BaktiyarBr/FB2ETH_RTL8213B/FB2ETH/production/bom.csv

Designator | Footprint | Quantity | Value | LCSC Part #
C19, C20 | 1206 | 2 | 22u
C25, C34 | 1206 | 2 | 10u
CN1 | CONN-SMD_20P-P0.80_HCTL_HC-SFP-20P | 1 | HC-SFP-20P
J1 | JST_SH_SM06B-SRSS-TB_1x06-1MP_P1.00mm_Horizontal | 1 | Conn_01x06_MountingPin
L1 | L_Changjiang_FTC252012S | 1 | 2u2
L2 | L_Changjiang_FXL0420 | 1 | 10uH
P6S1, P6S2, PWR1 | 0402 | 3 | ~
R8 | 0402 | 1 | 43k
U1 | VQFN-40-1EP_5x5mm_P0.4mm_EP3.7x3.7mm_ThermalVias | 1 | RTL8213B-CG
U3 | QFN-8_L3.0-W3.0-P0.65-BL | 1 | MP9943GQ-Z
U6 | TH_HC-SFP-01L | 1 | ~
X2 | Crystal_SMD_2016-4Pin_2.0x1.6mm | 1 | 25MHz
