BaktiyarBr/FB2ETH_RTL8213B/FB2ETH_2/FB2ETH_2/production/bom.csv

Designator | Footprint | Quantity | Value | LCSC Part #
C1, C2 | 0402 | 2 | 18pF
C15, C16, C17, C18, C21, C22, C23, C26, C27, C28, C29, C30, C31, C32, C33, C35, C36, C38, C39, C40, C41, C42, C43 | 0402 | 23 | 100n
C19, C20 | 1206 | 2 | 22u
C24 | 0603 | 1 | 100n
C25, C34 | 1206 | 2 | 10u
C37 | 0603 | 1 | 1u
CN1 | CONN-SMD_20P-P0.80_HCTL_HC-SFP-20P | 1 | HC-SFP-20P
J1 | JST_SH_SM06B-SRSS-TB_1x06-1MP_P1.00mm_Horizontal | 1 | Conn_01x06_MountingPin
L1 | L_Changjiang_FTC252012S | 1 | 2u2
L2 | L_Changjiang_FXL0420 | 1 | 10uH
P6S1, P6S2, PWR1 | 0402 | 3 | ~
R1, R10, R11, R2, R3, R4, R95 | 0402 | 7 | 4.7kΩ
R12, R7 | 0402 | 2 | 100k
R13 | 0402 | 1 | 1k
R5, R6, R99 | 0402 | 3 | 470Ω
R8 | 0402 | 1 | 43k
R82, R83, R86, R87, R90 | 0402 | 5 | 10kΩ
R9 | 0402 | 1 | 2.49kΩ
SCK1, SDA1 | TestPoint_Pad_2.0x2.0mm | 2 | ~
U1 | VQFN-40-1EP_5x5mm_P0.4mm_EP3.7x3.7mm_ThermalVias | 1 | RTL8213B-CG
U3 | QFN-8_L3.0-W3.0-P0.65-BL | 1 | MP9943GQ-Z
U6 | TH_HC-SFP-01L | 1 | ~
X2 | Crystal_SMD_2016-4Pin_2.0x1.6mm | 1 | 25MHz
