BaktiyarBr/FB2ETH_RTL8213B/FB2ETH_3/FB2ETH_3/production/bom.csv

Designator | Footprint | Quantity | Value | LCSC Part #
C19, C20 | 1206 | 2 | 22u
C25, C34 | 1206 | 2 | 10u
J1 | JST_SH_SM06B-SRSS-TB_1x06-1MP_P1.00mm_Horizontal | 1 | Conn_01x06_MountingPin
J2 | PinSocket_1x09_P2.54mm_Vertical | 1 | SFP_BIDI_01x09
L2 | L_Changjiang_FXL0420 | 1 | 10uH
P6S1, P6S2, PWR1 | 0402 | 3 | ~
R20, R21, R22, R26 | 0402 | 4 | 82
R23, R24, R25, R27 | 0402 | 4 | 130
R8 | 0402 | 1 | 43k
U1 | VQFN-40-1EP_5x5mm_P0.4mm_EP3.7x3.7mm_ThermalVias | 1 | RTL8213B-CG
U3 | QFN-8_L3.0-W3.0-P0.65-BL | 1 | MP9943GQ-Z
X2 | Crystal_SMD_2016-4Pin_2.0x1.6mm | 1 | 25MHz
