BaktiyarBr/FB2ETH_RTL8213B/FB2ETH/FB2ETH.csv

Reference | Qty | Value | DNP | Exclude from BOM | Exclude from Board | Footprint | LCSC Part Name
C19,C20 | 2 | 22u/50V |  |  |  | Capacitor_SMD:C_1206_3216Metric
C25,C34 | 2 | 10u/50V |  |  |  | Capacitor_SMD:C_1206_3216Metric
CN1 | 1 | HC-SFP-20P |  |  |  | projectLibs:CONN-SMD_20P-P0.80_HCTL_HC-SFP-20P | C2897292
J1 | 1 | Conn_01x06_MountingPin |  |  |  | Connector_JST:JST_SH_SM06B-SRSS-TB_1x06-1MP_P1.00mm_Horizontal | C3041141
L2 | 1 | 10uH |  |  |  | Inductor_SMD:L_Changjiang_FXL0420
P6S1,P6S2,PWR1 | 3 |  |  |  |  | LED_SMD:LED_0402_1005Metric
R8 | 1 | 43k |  |  |  | Resistor_SMD:R_0402_1005Metric
U1 | 1 | RTL8213B-CG |  |  |  | Package_DFN_QFN:VQFN-40-1EP_5x5mm_P0.4mm_EP3.7x3.7mm_ThermalVias | C2766076
U3 | 1 | MP9943GQ-Z |  |  |  | projectLibs:QFN-8_L3.0-W3.0-P0.65-BL | C51889390
U6 | 1 |  |  |  |  | projectLibs:TH_HC-SFP-01L | C2897291
X2 | 1 | 25MHz |  |  |  | Crystal:Crystal_SMD_2016-4Pin_2.0x1.6mm | C7301945
