BaktiyarBr/FB2ETH_RTL8213B/FB2ETH_2/FB2ETH_2/FB2ETH_2.csv

Reference | Qty | Value | DNP | Exclude from BOM | Exclude from Board | Footprint | Datasheet
C19,C20 | 2 | 22u |  |  |  | Capacitor_SMD:C_1206_3216Metric
C25,C34 | 2 | 10u |  |  |  | Capacitor_SMD:C_1206_3216Metric
CN1 | 1 | HC-SFP-20P |  |  |  | projectLibs:CONN-SMD_20P-P0.80_HCTL_HC-SFP-20P | https://atta.szlcsc.com/upload/public/pdf/source/20210914/BA7BB8E5B2F161D6EB896D34EBE70234.pdf
J1 | 1 | Conn_01x06_MountingPin |  |  |  | Connector_JST:JST_SH_SM06B-SRSS-TB_1x06-1MP_P1.00mm_Horizontal
L1 | 1 | 2u2 |  |  |  | Inductor_SMD:L_Changjiang_FTC252012S
L2 | 1 | 10uH |  |  |  | Inductor_SMD:L_Changjiang_FXL0420 | https://atta.szlcsc.com/upload/public/pdf/source/20200117/C485363_A2440626DC7482D75DD0DD56D1883FBF.pdf
P6S1,P6S2,PWR1 | 3 |  |  |  |  | LED_SMD:LED_0402_1005Metric | https://atta.szlcsc.com/upload/public/pdf/source/20200820/C130723_D39B4171A1B8D8D2F39C1DC521C0922A.pdf
R8 | 1 | 43k |  |  |  | Resistor_SMD:R_0402_1005Metric
U1 | 1 | RTL8213B-CG |  |  |  | Package_DFN_QFN:VQFN-40-1EP_5x5mm_P0.4mm_EP3.7x3.7mm_ThermalVias | https://atta.szlcsc.com/upload/public/pdf/source/20240125/4FAE948FC8054805EFA4DC6DA88B16DA.pdf
U3 | 1 | MP9943GQ-Z |  |  |  | projectLibs:QFN-8_L3.0-W3.0-P0.65-BL | 2021-05-22/374398S/94eb60b6438e46f987ac1f72df989e4b/MP9943.pdf
U6 | 1 |  |  |  |  | projectLibs:TH_HC-SFP-01L | https://atta.szlcsc.com/upload/public/pdf/source/20210914/D263BD6202628DAF148611CD07FFF2AC.pdf
X2 | 1 | 25MHz |  |  |  | Crystal:Crystal_SMD_2016-4Pin_2.0x1.6mm | https://item.szlcsc.com/datasheet/SX1B25.000F1210F30/8272198.html
