BaktiyarBr/FB2ETH_RTL8213B/from_epro/ProPrj_OpenIPC-Optical_2026-08-15.kicad_pcb

## KiCad design from_epro/ProPrj_OpenIPC-Optical_2026-08-15.kicad_pcb (2026-10-29)

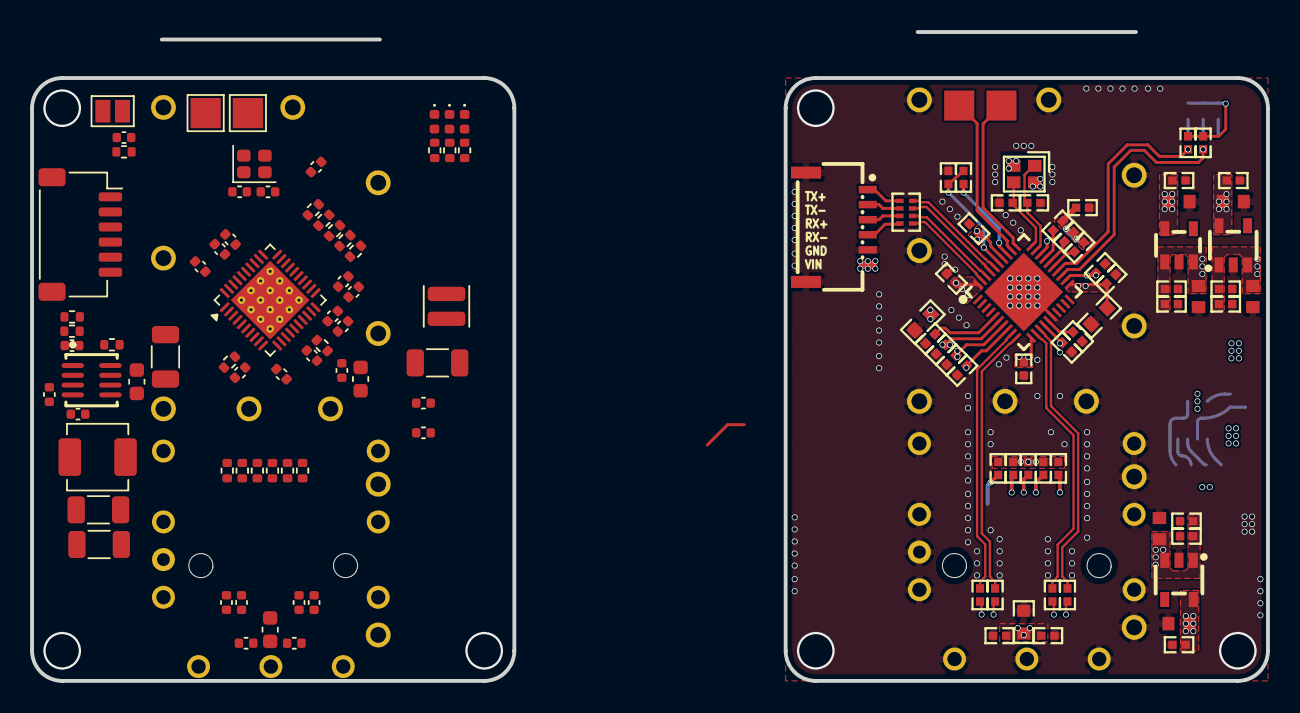
[picture p1: board ProPrj_OpenIPC-Optical_2026-08-15.kicad_pcb from above]

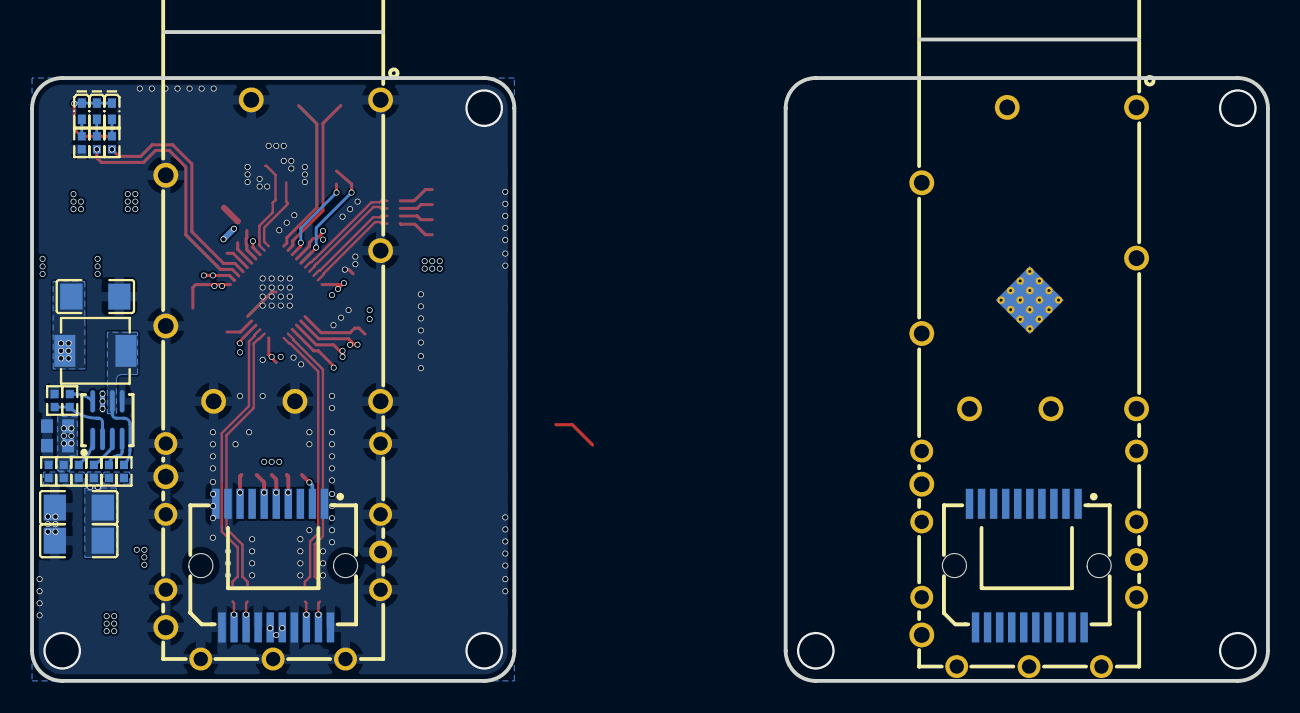
[picture p2: board ProPrj_OpenIPC-Optical_2026-08-15.kicad_pcb from below]

Board: 4 copper layers, 82.0 x 43.0 mm, 149 parts (25 on the bottom side), 92 nets.

Parts:
C1, C2#2: 18pF; C_0402_1005Metric
C1#2, C2, C3, C4, C5, C6, C7, C8, C10, C11, C12, C13, C14, C46, C68, C70, C71, C72, C73, C76, C81, C85, C88, C96, C97, C99, C100, C102: R0402
C9, C69, C75: R0603
C15, C16, C17, C18, C21, C22, C23, C26, C27, C28, C29, C30, C31, C32, C33, C35, C36, C38, C39, C40, C41, C42, C43, C44: 100n; C_0402_1005Metric
C15#2, C77, C80, C84, C94, C95, C98, C101: C0603
C18#2, C19#2, C93: C1206
C19, C20: 22u; C_1206_3216Metric
C20#2, C78: C0402
C24: 100n; C_0603_1608Metric
C25, C34: 10u; C_1206_3216Metric
C37, C45: 1u; C_0603_1608Metric
CN1: HC-SFP-20P; CONN-SMD_20P-P0.80_HCTL_HC-SFP-20P
CN1#2: CONN-SMD_20P-P0.80_HCTL_HC-SFP-20P
J1: Conn_01x06_MountingPin; JST_SH_SM06B-SRSS-TB_1x06-1MP_P1.00mm_Horizontal
JP1: SolderJumper_2_Open; SolderJumper-2_P1.3mm_Open_Pad1.0x1.5mm
L1: 2u2; L_Changjiang_FTC252012S
L1#2: IND-SMD_L4.4-W4.2
L2: 10uH; L_Changjiang_FXL0420
P6S0, P6S1#2: LED0402-RD
P6S1, P6S2: LED_0402_1005Metric
PWR: LED0402-RD
PWR1: LED_0402_1005Metric
R1, R2, R3, R4, R10, R11#2, R95#2: 4.7kΩ; R_0402_1005Metric
R1#2, R2#2, R3#2, R4#2, R5#2, R6#2, R9#2, R10#2, R11, R16, R17, R20, R82, R83, R86, R87#2, R90, R95, R96, R97, R98, R99#2: R0402
R5, R6, R99: 470Ω; R_0402_1005Metric
R7, R12: 100k; R_0402_1005Metric
R8: 43k; R_0402_1005Metric
R9: 2.49kΩ; R_0402_1005Metric
R13: 1k; R_0402_1005Metric
R82#2, R83#2, R86#2, R87, R90#2: 10kΩ; R_0402_1005Metric
RN1: RES-ARRAY-SMD_0402-8P-L2.0-W1.0-BL
SCK: Test-Point-0.5mm
SCK1: TestPoint_Pad_2.0x2.0mm
SDA: Test-Point-0.5mm
SDA1: TestPoint_Pad_2.0x2.0mm
TOMinBoard: CONN-SMD_6P-P1.00_HDGC1002WR-S-6P
U1: RTL8213B-CG; VQFN-40-1EP_5x5mm_P0.4mm_EP3.7x3.7mm_ThermalVias
U1#2: QFN-40_L5.0-W5.0-P0.40-BL-EP3.7
U2: QFN-8_L3.0-W3.0-P0.65-BL
U3: MP9943GQ-Z; QFN-8_L3.0-W3.0-P0.65-BL
U6: TH_HC-SFP-01L
U6#2: TH_HC-SFP-01L
U7, U8: SOT-23-5_L3.0-W1.7-P0.95-LS2.8-BR
U10: SOT-23-5_L2.9-W1.6-P0.95-LS2.8-BL
X2: 25MHz; Crystal_SMD_2016-4Pin_2.0x1.6mm
X2#2: CRYSTAL-SMD_4P-L2.0-W1.6-BL

Connections:
4V5: C15#2.2, C46.1, C77.2, C81.2, C85.2, C88.1, C93.1, C94.2, C95.2, C99.2, C100.1, C101.2, L1#2.2, R17.2, U7.1, U7.3, U8.1, U8.3, U10.1, U10.3
8213B_1V0: C3.2, C4.2, C5.2, C6.2, C7.2, C8.2, C75.2, C98.2, C102.1, U1#2.6, U1#2.8, U1#2.11, U1#2.22, U1#2.34, U1#2.40, U10.5
8213B_3V3: C9.2, C10.2, C11.2, C12.2, C13.2, C14.2, C80.2, C96.1, P6S0.1, P6S1#2.1, PWR.1, R1#2.2, R2#2.1, R3#2.2, R4#2.2, R10#2.2, R95.2, U1#2.7, U1#2.14, U1#2.21, U1#2.28, U1#2.35, U7.5
8213B_EN_SWR: R11.2, U1#2.15
8213B_SCK: SCK.1, U1#2.32
8213B_SDA: SDA.1, U1#2.31
$1N1852: C1#2.1, U1#2.29, X2#2.1
$1N1863: R10#2.1, U1#2.33
$1N1904: R9#2.2, U1#2.5
$1N1912: C2.2, U1#2.30, X2#2.3
$1N1945: P6S1#2.2, R5#2.2
$1N1946: P6S0.2, R6#2.2
$1N2817: CN1#2.5, R86.1
$1N2818: CN1#2.4, R83.1
$1N2820: CN1#2.6, R87#2.1
$1N2821: CN1#2.2, R82.1
$1N2827: CN1#2.8, R90.1
$1N6453: PWR.2, R99#2.2
$2N900: R97.2, U2.8
$2N902: C20#2.2, R98.2
$2N903: C78.2, R97.1, U2.2
$2N910: R16.2, R17.1, R20.2
$2N915: C20#2.1, U2.4
$2N918: R96.2, U2.3
+1V1: C28.1, C29.1, C30.1, C31.1, C32.1, C33.1, C34.1, L1.1, U1.6 (AVDDL), U1.8 (DVDDL), U1.11 (SVDDL), U1.22 (DVDDL), U1.34 (PLLVDDL), U1.40 (AVDDL)
+3V3: C16.1, C18.1, C19.1, C20.1, C21.1, C22.1, C26.1, C27.1, C35.1, C36.1, C37.1, C42.1, C43.1, C44.1, C45.1, CN1.15, CN1.16, L2.2, P6S1.1 (A), P6S2.1 (A), PWR1.1 (A), R1.2, R2.1, R3.2, R4.2, R7.1, R10.2, R11#2.1, R82#2.2, R83#2.2, R86#2.2, R87.2, R90#2.2, R95#2.2, U1.7 (AVDDH), U1.14 (AVDDH), U1.19 (HV_SWR), U1.20 (HV_SWR), U1.21 (DVDDIO), U1.28 (AVDDH), U1.35 (AVDDH)
/8213B_SCK: SCK1.1 (1_1), U1.32 (SCK)
/8213B_SDA: SDA1.1 (1_1), U1.31 (SDA)
/ETH_RX+: J1.3, U1.38 (P3MDIBP)
/ETH_RX-: J1.4, U1.39 (P3MDIBN)
/ETH_TX+: J1.1, U1.36 (P3MDIAP)
/ETH_TX-: J1.2, U1.37 (P3MDIAN)
/HSIN: C41.2, U1.13 (HSIN)
/HSIP: C40.2, U1.12 (HSIP)
/HSON: C38.2, U1.9 (HSON)
/HSOP: C39.2, U1.10 (HSOP)
/P3LED0: R1.1, U1.27 (GPO52/P3LED0/SMI_SEL)
/P3LED1: R95#2.1, U1.26 (GPIO51/P3LED1)
/P3LED2: R2.2, U1.25 (GPO50/P3LED2/EN_PHY)
/P6LED0: R3.1, R6.1, U1.24 (GPIO48/P6LED0/MID29)
/P6LED1: R4.1, R5.1, U1.23 (GPO45/P6LED1/DISAUTOLOAD)
/SFP_RX_N: C41.1, CN1.12
/SFP_RX_P: C40.1, CN1.13
/SFP_TX_N: C38.1, CN1.19
/SFP_TX_P: C39.1, CN1.18
ETH_RX+: RN1.2, TOMinBoard.3
ETH_RX-: RN1.1, TOMinBoard.4
ETH_TX+: RN1.4, TOMinBoard.1
ETH_TX-: RN1.3, TOMinBoard.2
FB_5V: R16.1, U2.1
GND: C1.2, C1#2.2, C2.1, C2#2.1, C3.1, C4.1, C5.1, C6.1, C7.1, C8.1, C9.1, C10.1, C11.1, C12.1, C13.1, C14.1, C15.2, C15#2.1, C16.2, C18#2.1, C19.2, C19#2.1, C20.2, C21.2, C22.2, C23.2, C24.2, C25.2, C26.2, C27.2, C28.2, C29.2, C30.2, C31.2, C32.2, C33.2, C34.2, C35.2, C36.2, C37.2, C42.2, C43.2, C44.2, C45.2, C46.2, C68.1, C69.1, C75.1, C76.1, C77.1, C78.1, C80.1, C81.1, C84.1, C85.1, C88.2, C93.2, C94.1, C95.1, C96.2, C97.2, C98.1, C99.1, C100.2, C101.1, C102.2, CN1.1, CN1.9, CN1.10, CN1.11, CN1.14, CN1.17, CN1.20, CN1#2.1, CN1#2.9, CN1#2.10, CN1#2.11, CN1#2.14, CN1#2.17, CN1#2.20, J1.5, J1.MP (MountPin), JP1.1 (A), R8.2, R9.1, R9#2.1, R11.1, R13.2, R20.1, R99.1, R99#2.1, TOMinBoard.5, TOMinBoard.7, TOMinBoard.8, U1.16 (GND_SWR), U1.41 (EP), U1#2.16, U1#2.41, U2.5, U3.5 (GND), U6.1, U6.2, U6.3, U6.4, U6.5, U6.6, U6.7, U6.8, U6.9, U6.10, U6.11, U6.12, U6.13, U6.14, U6.15, U6.16, U6.17, U6.18, U6.19, U6.20, U6#2.1, U6#2.2, U6#2.3, U6#2.4, U6#2.5, U6#2.6, U6#2.7, U6#2.8, U6#2.9, U6#2.10, U6#2.11, U6#2.12, U6#2.13, U6#2.14, U6#2.15, U6#2.16, U6#2.17, U6#2.18, U6#2.19, U6#2.20, U7.2, U8.2, U10.2, X2.2 (GND), X2.4 (GND), X2#2.2, X2#2.4
HSIN: C73.2, U1#2.13
HSIP: C72.2, U1#2.12
HSON: C70.2, U1#2.9
HSOP: C71.2, U1#2.10
LC_5V: L1#2.1, R98.1, U2.6
unnamed: CN1.2, R82#2.1
unnamed: CN1.3, R13.1
unnamed: CN1.4, R83#2.1
unnamed: CN1.5, R86#2.1
unnamed: CN1.6, R87.1
unnamed: CN1.8, R90#2.1
unnamed: C15.1, JP1.2 (B), R10.1, U1.33 (nRESET)
unnamed: L1.2, U1.17 (LX), U1.18 (LX)
unnamed: P6S1.2 (K), R5.2
unnamed: P6S2.2 (K), R6.2
unnamed: PWR1.2 (K), R99.2
unnamed: R11#2.2, U1.15 (EN_SWR)
unnamed: R9.2, U1.5 (MDIREF)
unnamed: C2#2.2, U1.30 (XTALI), X2.3
unnamed: C1.1, U1.29 (XTALO), X2.1
unnamed: C17.1, U3.4 (BST)
unnamed: C18.2, R7.2, R8.1, U3.1 (FB)
unnamed: R12.1, U3.8 (PG)
unnamed: C17.2, L2.1, U3.6 (SW)
unnamed: C23.1, R12.2, U3.2 (VCC)
P0MDIAN: RN1.6, U1#2.37
P0MDIAP: RN1.5, U1#2.36
P0MDIBN: RN1.8, U1#2.39
P0MDIBP: RN1.7, U1#2.38
P3LED0: R1#2.1, U1#2.27
P3LED1: R95.1, U1#2.26
P3LED2: R2#2.2, U1#2.25
P6LED0: R3#2.1, R6#2.1, U1#2.24
P6LED1: R4#2.1, R5#2.1, U1#2.23
SFP_3V3: C68.2, C69.2, C76.2, C84.2, C97.1, CN1#2.15, CN1#2.16, R82.2, R83.2, R86.2, R87#2.2, R90.2, U8.5
SFP_RX_N: C73.1, CN1#2.12
SFP_RX_P: C72.1, CN1#2.13
SFP_TX_N: C70.1, CN1#2.19
SFP_TX_P: C71.1, CN1#2.18
VBAT: C18#2.2, C19#2.2, R96.1, TOMinBoard.6, U2.7
VBUS: C24.1, C25.1, J1.6, U3.3 (EN/SYNC), U3.7 (IN)
